FLJHH/iot-greenhouse-management-system/代码/上位机代码/说明.txt

登录id：8632
用户名和密码都是：123

index.html是主页
***********************************************
此文件具有访问数据库的功能，function db_request_option(type, table, option, arg_data, callback)
通过json格式的数据来判断请求的渠道并跳转到响应的登录页面，window.location.replace(pc_login_url);

***********************************************

main_9.html是主页
***********************************************
这段代码是一个HTML和Vue.js混合编写的桌面应用程序。它的功能包括导航栏、侧边栏、内容窗口和登录页面。以下是输入代码的解释：
代码结构：
使用<!DOCTYPE html>定义了一个HTML文档的声明。
使用<html>、<head>和<body>标签组织网页的结构。
在<head>中包含了<meta>标签、<link>标签和<style>标签。
在<body>中使用了Vue.js框架和Element UI组件。
实现原理：
使用Vue.js框架实现了一个单页应用（SPA），包括数据绑定、视图渲染和状态管理。
使用Element UI组件实现了一个美观的界面，包括导航栏、侧边栏和内容窗口。
使用了v-cloak指令来控制元素的显示和隐藏。
用途：
这是一个桌面应用程序，用于展示和操作数据。
用户可以通过导航栏和侧边栏快速定位到所需的页面和功能。
内容窗口展示了数据，用户可以查看和修改数据。
登录页面提供了用户登录和注册的功能。
***********************************************
login.html是登录页面

register.html是注册页面

user.html是用户信息页面

user_update.html是修改用户信息页面

user_update_pwd.html是修改密码页面

user_update_pwd_success.html是修改密码成功页面

user_update_success.html是修改用户信息成功页面

user_update_fail.html是修改用户信息失败页面

user_update_pwd_fail.html是修改密码失败页面

user_update_pwd_success.html是修改密码成功页面

user_update_pwd_fail.html是修改密码失败页面

user_update_pwd_success.html是修改密码成功页面

user_update_fail.html是修改用户信息失败页面
