FLJHH/iot-greenhouse-management-system/代码/上位机代码/html/login_page_3/asset/img1.png

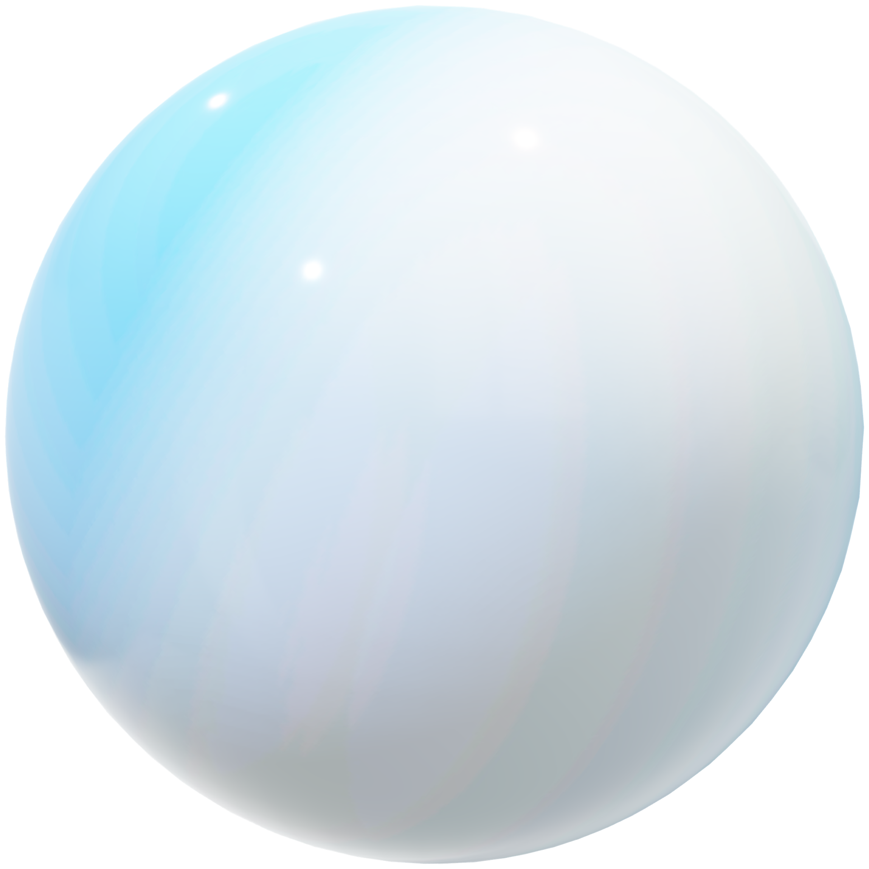
代码/上位机代码/html/login_page_3/asset/img1.png
