FLJHH/iot-greenhouse-management-system/代码/上位机代码/img/3.jpg

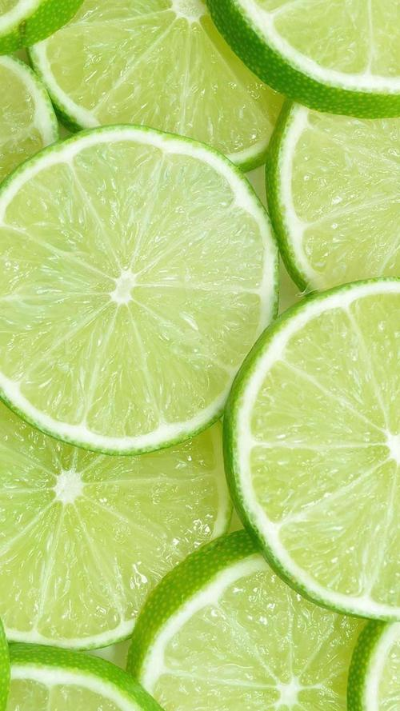
代码/上位机代码/img/3.jpg
