FLJHH/iot-greenhouse-management-system/代码/上位机代码/img/4.png

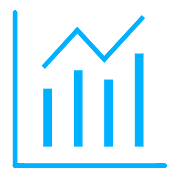
代码/上位机代码/img/4.png
