FLJHH/iot-greenhouse-management-system/代码/上位机代码/img/12.jpg

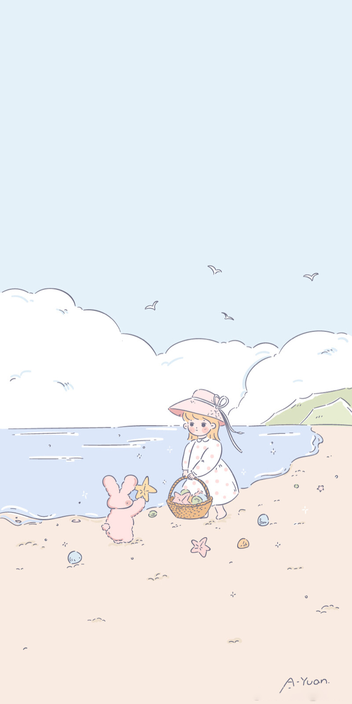
代码/上位机代码/img/12.jpg
