FLJHH/iot-greenhouse-management-system/代码/上位机代码/img/26.jpg

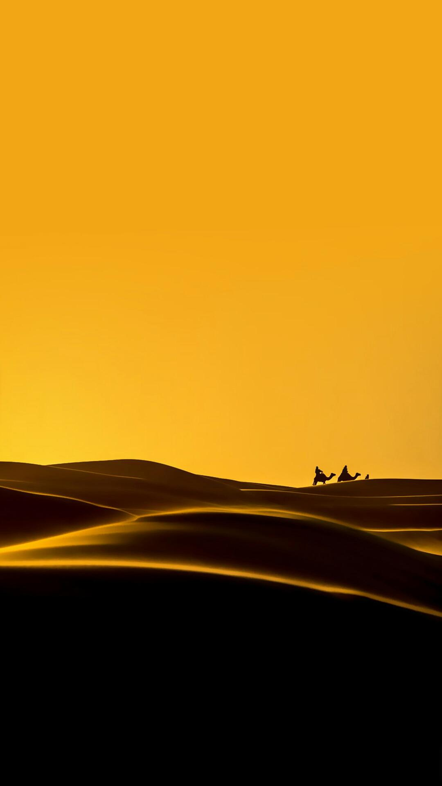
代码/上位机代码/img/26.jpg
