FLJHH/iot-greenhouse-management-system/代码/上位机代码/img/33.jpg

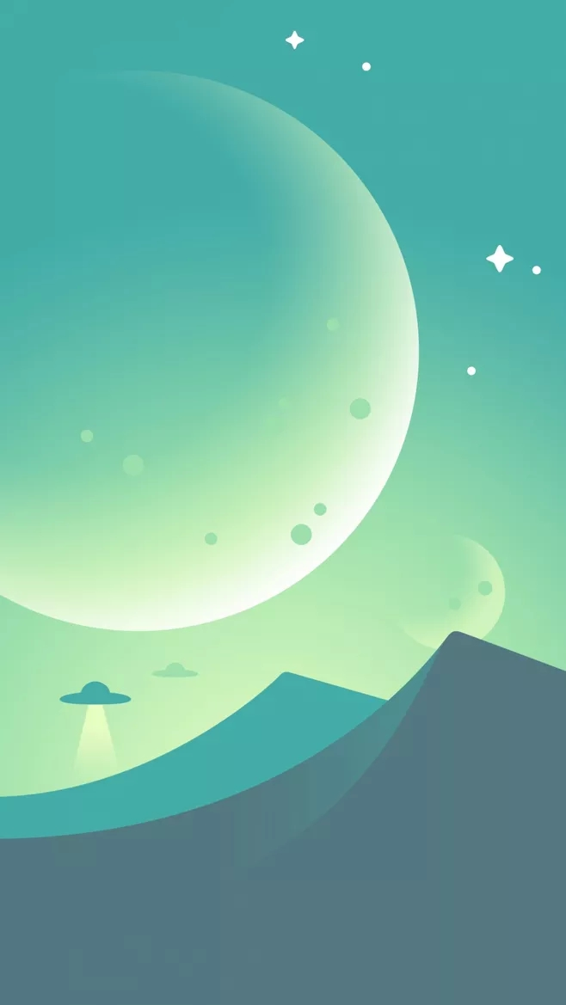
代码/上位机代码/img/33.jpg
