FLJHH/iot-greenhouse-management-system/代码/上位机代码/img/2512.jpg

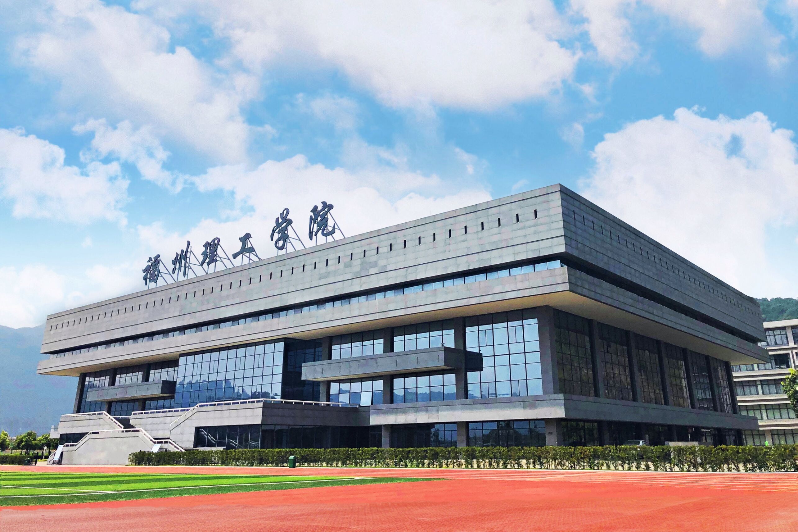
代码/上位机代码/img/2512.jpg
