FLJHH/iot-greenhouse-management-system/代码/上位机代码/img/pc/背景5.jpg

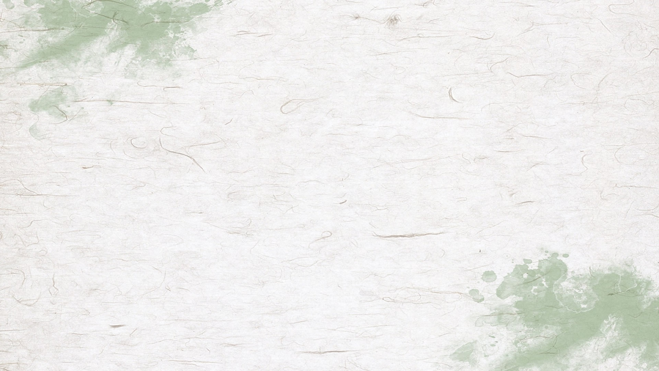
代码/上位机代码/img/pc/背景5.jpg
