FLJHH/iot-greenhouse-management-system/代码/上位机代码/img/腾讯云背景.jpg

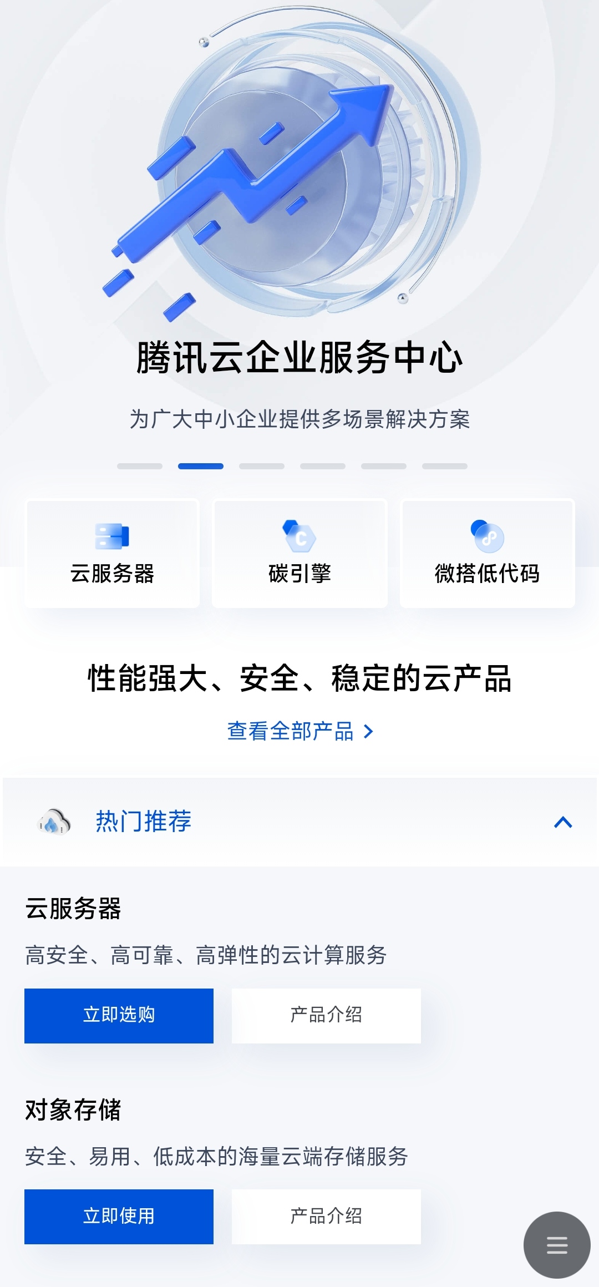
代码/上位机代码/img/腾讯云背景.jpg
