FLJHH/iot-greenhouse-management-system/代码/下位机代码/stm32-1/stm32-lib-softtimer/HARDWARE/GPIO_Init/GPIO_Init.c

#include "GPIO_Init.h"

// -------AO读取----

unsigned int Get_GPIO_Init_Mode_AO_PA0(void)
{
	unsigned int value;
	static unsigned char flag_is_init = 0;
	if (flag_is_init == 0)
	{
		flag_is_init = 1;
		Adc_Init_channel(0);
	}

	value = Get_ADC_channel(0); // channel and repeat times

	return value;
}

unsigned int Get_GPIO_Init_Mode_AO_PA1(void)
{
	unsigned int value;
	static unsigned char flag_is_init = 0;
	if (flag_is_init == 0)
	{
		flag_is_init = 1;
		Adc_Init_channel(1);
	}

	value = Get_ADC_channel(1); // channel and repeat times

	return value;
}

unsigned int Get_GPIO_Init_Mode_AO_PA2(void)
{
	unsigned int value;
	static unsigned char flag_is_init = 0;
	if (flag_is_init == 0)
	{
		flag_is_init = 1;
		Adc_Init_channel(2);
	}

	value = Get_ADC_channel(2); // channel and repeat times

	return value;
}

unsigned int Get_GPIO_Init_Mode_AO_PA3(void)
{
	unsigned int value;
	static unsigned char flag_is_init = 0;
	if (flag_is_init == 0)
	{
		flag_is_init = 1;
		Adc_Init_channel(3);
	}

	value = Get_ADC_channel(3); // channel and repeat times

	return value;
}
// 功能：获取GPIO初始化模式AO_PA4的值
// 参数：无
// 返回值：unsigned int类型的值
unsigned int Get_GPIO_Init_Mode_AO_PA4(void)
{
	unsigned int value;
	static unsigned char flag_is_init = 0; // 初始化标志位
	if (flag_is_init == 0) // 如果未初始化
	{
		flag_is_init = 1; // 初始化标志位设为1
		Adc_Init_channel(4); // 初始化ADC通道4
	}

	value = Get_ADC_channel(4); // 获取ADC通道4的值

	return value;
}
unsigned int Get_GPIO_Init_Mode_AO_PA5(void)
{
	unsigned int value;
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
		GPIO_Init(GPIOC, &GPIO_InitStructure);			  // 根据设定参数初始化GPIOA.8
		GPIO_ResetBits(GPIOC, GPIO_Pin_15);				  // 输出低
	}

	if (value)
	{
		GPIO_ResetBits(GPIOC, GPIO_Pin_15); // 输出低电平
	}
	else
	{
		GPIO_SetBits(GPIOC, GPIO_Pin_15); // 输出高
	}
}
