FLJHH/iot-greenhouse-management-system/代码/下位机代码/stm32-网关中转/stm32-lib-softtimer/HARDWARE/GPIO/GPIO.C

#include "gpio.h"
#include "delay.h"   //根据时钟晶振配置的延时函数
#include "sys.h"			//基础配置（包括 gpio输入输出简化 及变量名的简化

void GPIO_Init_Mode(void)
{

	GPIO_InitTypeDef GPIO_InitStructure;

	RCC_APB2PeriphClockCmd(RCC_APB2Periph_GPIOE, ENABLE); //使能PG,PD端口时钟

	GPIO_InitStructure.GPIO_Pin = GPIO_Pin_14;		  // 端口配置
	GPIO_InitStructure.GPIO_Mode = GPIO_Mode_Out_PP;  //设置成上拉输入
	GPIO_InitStructure.GPIO_Speed = GPIO_Speed_50MHz; //IO口速度为50MHz
	GPIO_Init(GPIOE, &GPIO_InitStructure);			  //根据设定参数初始化GPIOA.8
	GPIO_SetBits(GPIOE, GPIO_Pin_14);				  // 输出高

	// GPIO_InitStructure.GPIO_Pin = GPIO_Pin_9;				 //LED0-->PA.8 端口配置
	// GPIO_InitStructure.GPIO_Mode = GPIO_Mode_Out_PP; 		 //推挽输出
	// GPIO_InitStructure.GPIO_Speed = GPIO_Speed_50MHz;		 //IO口速度为50MHz
	// GPIO_Init(GPIOE, &GPIO_InitStructure);					 //根据设定参数初始化GPIOA.8
	// GPIO_ResetBits(GPIOE,GPIO_Pin_9);						 //PA.8 输出低

	// GPIO_InitStructure.GPIO_Pin = GPIO_Pin_9;	    		 //LED1-->PD.2 端口配置, 推挽输出
	// GPIO_Init(GPIOE, &GPIO_InitStructure);	  				 //推挽输出 ，IO口速度为50MHz
	// GPIO_SetBits(GPIOE,GPIO_Pin_9); 						 //PD.2 输出高
}

void InitSensor_Beep(void)
{

	GPIO_InitTypeDef GPIO_InitStructure;

	RCC_APB2PeriphClockCmd(RCC_APB2Periph_GPIOB, ENABLE); //使能PG,PD端口时钟

	GPIO_InitStructure.GPIO_Pin = GPIO_Pin_10;		  // 端口配置
	GPIO_InitStructure.GPIO_Mode = GPIO_Mode_Out_PP;  //设置成上拉输入
	GPIO_InitStructure.GPIO_Speed = GPIO_Speed_50MHz; //IO口速度为50MHz
	GPIO_Init(GPIOB, &GPIO_InitStructure);			  //根据设定参数初始化GPIOA.8
	GPIO_SetBits(GPIOB, GPIO_Pin_10);				  // 输出高 -- 低电平触发
}
 



void InitSensor_OUTPUT_DO2(void)
{

	GPIO_InitTypeDef GPIO_InitStructure;

	RCC_APB2PeriphClockCmd(RCC_APB2Periph_GPIOB, ENABLE); //使能PB端口时钟

	GPIO_InitStructure.GPIO_Pin = GPIO_Pin_12;		  // 端口配置
	GPIO_InitStructure.GPIO_Mode = GPIO_Mode_Out_PP;  //设置成上拉输入
	GPIO_InitStructure.GPIO_Speed = GPIO_Speed_50MHz; //IO口速度为50MHz
	GPIO_Init(GPIOB, &GPIO_InitStructure);			  //根据设定参数初始化GPIOA.8
	GPIO_ResetBits(GPIOB, GPIO_Pin_12);				  // 输出低
}

void InitSensor_OUTPUT_DO3(void)
{

	GPIO_InitTypeDef GPIO_InitStructure;

	RCC_APB2PeriphClockCmd(RCC_APB2Periph_GPIOB, ENABLE); //使能PB端口时钟

	GPIO_InitStructure.GPIO_Pin = GPIO_Pin_13;		  // 端口配置
	GPIO_InitStructure.GPIO_Mode = GPIO_Mode_Out_PP;  //设置成上拉输入
	GPIO_InitStructure.GPIO_Speed = GPIO_Speed_50MHz; //IO口速度为50MHz
	GPIO_Init(GPIOB, &GPIO_InitStructure);			  //根据设定参数初始化GPIOA.8
	GPIO_ResetBits(GPIOB, GPIO_Pin_13);				  // 输出低
}

void InitSensor_OUTPUT_DO4(void)
{

	GPIO_InitTypeDef GPIO_InitStructure;

	RCC_APB2PeriphClockCmd(RCC_APB2Periph_GPIOB, ENABLE); //使能PB端口时钟

	GPIO_InitStructure.GPIO_Pin = GPIO_Pin_14;		  // 端口配置
	GPIO_InitStructure.GPIO_Mode = GPIO_Mode_Out_PP;  //设置成上拉输入
	GPIO_InitStructure.GPIO_Speed = GPIO_Speed_50MHz; //IO口速度为50MHz
	GPIO_Init(GPIOB, &GPIO_InitStructure);			  //根据设定参数初始化GPIOA.8
	GPIO_ResetBits(GPIOB, GPIO_Pin_14);				  // 输出低
}

void InitSensor_OUTPUT_DO5(void)
{

	GPIO_InitTypeDef GPIO_InitStructure;

	RCC_APB2PeriphClockCmd(RCC_APB2Periph_GPIOB, ENABLE); //使能PB端口时钟

	GPIO_InitStructure.GPIO_Pin = GPIO_Pin_15;		  // 端口配置
	GPIO_InitStructure.GPIO_Mode = GPIO_Mode_Out_PP;  //设置成上拉输入
	GPIO_InitStructure.GPIO_Speed = GPIO_Speed_50MHz; //IO口速度为50MHz
	GPIO_Init(GPIOB, &GPIO_InitStructure);			  //根据设定参数初始化GPIOA.8
	GPIO_ResetBits(GPIOB, GPIO_Pin_15);				  // 输出低电平
}






void InitSensor_Jidianqi(void)
{

	GPIO_InitTypeDef GPIO_InitStructure;

	RCC_APB2PeriphClockCmd(RCC_APB2Periph_GPIOB, ENABLE); //使能PB端口时钟

	GPIO_InitStructure.GPIO_Pin = GPIO_Pin_7;		  // 端口配置
	GPIO_InitStructure.GPIO_Mode = GPIO_Mode_Out_PP;  //设置成上拉输入
	GPIO_InitStructure.GPIO_Speed = GPIO_Speed_50MHz; //IO口速度为50MHz
	GPIO_Init(GPIOB, &GPIO_InitStructure);			  //根据设定参数初始化GPIOA.8
	GPIO_ResetBits(GPIOB, GPIO_Pin_7);				  // 输出低电平
}




void InitSensor_Jidianqi_2(void)
{

	GPIO_InitTypeDef GPIO_InitStructure;

	RCC_APB2PeriphClockCmd(RCC_APB2Periph_GPIOB, ENABLE); //使能PB端口时钟

	GPIO_InitStructure.GPIO_Pin = GPIO_Pin_6;		  // 端口配置
	GPIO_InitStructure.GPIO_Mode = GPIO_Mode_Out_PP;  //设置成上拉输入
	GPIO_InitStructure.GPIO_Speed = GPIO_Speed_50MHz; //IO口速度为50MHz
	GPIO_Init(GPIOB, &GPIO_InitStructure);			  //根据设定参数初始化GPIOA.8
	GPIO_ResetBits(GPIOB, GPIO_Pin_6);				  // 输出低电平
}


void InitSensor_Jidianqi_3(void)
{

	GPIO_InitTypeDef GPIO_InitStructure;

	RCC_APB2PeriphClockCmd(RCC_APB2Periph_GPIOB, ENABLE); //使能PB端口时钟

	GPIO_InitStructure.GPIO_Pin = GPIO_Pin_5;		  // 端口配置
	GPIO_InitStructure.GPIO_Mode = GPIO_Mode_Out_PP;  //设置成上拉输入
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

	state = GPIO_ReadInputDataBit(GPIOB, GPIO_Pin_8);

	if (state == 0)
	{
		record = ((record << 1) | 0x01);
	}
	else
	{
		record = ((record << 1) & (~0x01));
	}

	if ((record & 0xf) == 0)
	{
		return (0);
	}
	else
	{
		return (1);
	}
}







void InitSensor_Renti(void)
{

	GPIO_InitTypeDef GPIOInit;
	RCC_APB2PeriphClockCmd(RCC_APB2Periph_GPIOB, ENABLE);
	GPIOInit.GPIO_Mode = GPIO_Mode_IPU;
	GPIOInit.GPIO_Pin = GPIO_Pin_9;
	GPIOInit.GPIO_Speed = GPIO_Speed_50MHz;
	GPIO_Init(GPIOB, &GPIOInit);
}


void InitSensor_Huoyan(void)
{

	GPIO_InitTypeDef GPIOInit;
	RCC_APB2PeriphClockCmd(RCC_APB2Periph_GPIOB, ENABLE);
	GPIOInit.GPIO_Mode = GPIO_Mode_IPU;
	GPIOInit.GPIO_Pin = GPIO_Pin_4;
	GPIOInit.GPIO_Speed = GPIO_Speed_50MHz;
	GPIO_Init(GPIOB, &GPIOInit);
}




unsigned char Get_Huoyan(void)
{

	static unsigned char record = 0;
	unsigned char i = 0;
	unsigned char state = 0;

	state = GPIO_ReadInputDataBit(GPIOB, GPIO_Pin_4);

	if (state == 0)
	{
		record = ((record << 1) | 0x01);
	}
	else
	{
		record = ((record << 1) & (~0x01));
	}

	if ((record & 0x7) == 0)   // 0x07   ==  00000111
	{
		return (0);
	}
	else
	{
		return (1);
	}
}





unsigned char Get_Renti(void)
{

	static unsigned char record = 0;
	unsigned char i = 0;
	unsigned char state = 0;

	state = GPIO_ReadInputDataBit(GPIOB, GPIO_Pin_9);

	if (state == 1)
	{
		record = ((record << 1) | 0x01);
	}
	else
	{
		record = ((record << 1) & (~0x01));
	}

	if ((record & 0x0f) == 0)
	{
		return (0);
	}
	else
	{
		return (1);
	}
}





void InitSensor_Key(void)  
{  
    GPIO_InitTypeDef GPIOInit;  
    RCC_APB2PeriphClockCmd(RCC_APB2Periph_GPIOA, ENABLE);  
      
    GPIOInit.GPIO_Mode = GPIO_Mode_IPU;   //上拉输入
    GPIOInit.GPIO_Pin = GPIO_Pin_8 ;  
    GPIOInit.GPIO_Speed = GPIO_Speed_50MHz;  
    GPIO_Init(GPIOA, &GPIOInit);  
}  



  
unsigned char Get_Key(void)  
{  
	
	if(GPIO_ReadInputDataBit(GPIOA, GPIO_Pin_8) == 0)
	{
		delay_ms(10);
		
		if(GPIO_ReadInputDataBit(GPIOA, GPIO_Pin_8) == 0)
		{
			return 1;
		}
	}
	return 0;
}  
