FLJHH/iot-greenhouse-management-system/代码/下位机代码/stm32-网关中转/stm32-lib-softtimer/HARDWARE/PWM/pwm.c

#include "pwm.h"
#include "led.h"

/********************************************	 
 TIMx 
TIM1_BKIN->PB12
TIM1_CH1N->PB13
TIM1_CH2N->PB14
TIM1_CH3N->PB15
TIM1_CH1->PA8
TIM1_CH2->PA9
TIM1_CH3->PA10
TIM1_CH4->PA11
TIM1_ETR->PA12
TIM2_CH1->PA0
TIM2_CH2->PA1
TIM2_CH3->PA2
TIM2_Ch4->PA3
TIM3_ETR->PD2
TIM3_CH1->PB4-PC6-Remap
TIM3_CH2->PB5-PC7-Remap
TIM3_CH3->PC8-Remap
TIM3_CH4->PC9-Remap
TIM4_CH1->PD12-Remap
TIM4_CH2->PD13-Remap
TIM4_CH3->PD14-Remap
TIM4_CH4->PD15-Remap
TIM5_CH1->PA0
TIM5_CH2->PA1
TIM5_CH3->PA2
TIM5_CH4->PA3
TIM8_ETR->PA0
TIM8_BKIN->PA6
TIM8_CH1N->PA7
TIM8_CH2N->PB0
TIM8_CH3N->PB1
TIM8_CH1->PC6
TIM8_CH2->PC7
TIM8_CH3->PC8
TIM8_CH4->PC9
*************************************************************/ 	  



//PWM输出初始化
//arr：自动重装值
//psc：时钟预分频数
//TIM_SetCompare1(TIM1,NUM); --控制TIM1 CH1 占空比为NUM

void TIM1_PWM_Init(u16 arr,u16 psc)
{  
   GPIO_InitTypeDef GPIO_InitStructure;
  TIM_TimeBaseInitTypeDef  TIM_TimeBaseStructure;
  TIM_OCInitTypeDef  TIM_OCInitStructure;

  RCC_APB2PeriphClockCmd(RCC_APB2Periph_TIM1, ENABLE);		// 
  RCC_APB2PeriphClockCmd(RCC_APB2Periph_GPIOA , ENABLE);  //使能GPIO外设时钟使能
                                                                        

   //设置该引脚为复用输出功能,输出TIM1 CH1的PWM脉冲波形
  GPIO_InitStructure.GPIO_Pin = GPIO_Pin_10 | GPIO_Pin_11; //TIM_CH1 TIM_CH4
  GPIO_InitStructure.GPIO_Mode = GPIO_Mode_AF_PP;  //复用推挽输出
  GPIO_InitStructure.GPIO_Speed = GPIO_Speed_50MHz;
  GPIO_Init(GPIOA, &GPIO_InitStructure);

  
  TIM_TimeBaseStructure.TIM_Period = arr-1; //设置在下一个更新事件装入活动的自动重装载寄存器周期的值  80K
  TIM_TimeBaseStructure.TIM_Prescaler =psc-1; //设置用来作为TIMx时钟频率除数的预分频值  不分频
  TIM_TimeBaseStructure.TIM_ClockDivision = 0; //设置时钟分割:TDTS = Tck_tim
  TIM_TimeBaseStructure.TIM_CounterMode = TIM_CounterMode_Up;  //TIM向上计数模式
  TIM_TimeBaseInit(TIM1, &TIM_TimeBaseStructure); //根据TIM_TimeBaseInitStruct中指定的参数初始化TIMx的时间基数单位



 
  TIM_OCInitStructure.TIM_OCMode = TIM_OCMode_PWM2; //选择定时器模式:TIM脉冲宽度调制模式2
  TIM_OCInitStructure.TIM_OutputState = TIM_OutputState_Enable; //比较输出使能
  TIM_OCInitStructure.TIM_Pulse = 0; //设置待装入捕获比较寄存器的脉冲值
  TIM_OCInitStructure.TIM_OCPolarity = TIM_OCPolarity_High; //输出极性:TIM输出比较极性高
  TIM_OC1Init(TIM1, &TIM_OCInitStructure);  //根据TIM_OCInitStruct中指定的参数初始化外设TIMx
	
	
	TIM_OC1Init(TIM1, &TIM_OCInitStructure);  //根据TIM_OCInitStruct中指定的参数初始化外设TIMx ----------- TIM_OC3 通道3
  TIM_OC4Init(TIM1, &TIM_OCInitStructure);  //根据TIM_OCInitStruct中指定的参数初始化外设TIMx ----------- TIM_OC4 通道4


  TIM_CtrlPWMOutputs(TIM1,ENABLE);  //MOE 主输出使能 

	// TIM_OC1PreloadConfig(TIM1, TIM_OCPreload_Enable);  //CH1预装载使能  
  // TIM_OC2PreloadConfig(TIM1, TIM_OCPreload_Enable);  //CH1预装载使能  
  TIM_OC3PreloadConfig(TIM1, TIM_OCPreload_Enable);  //CH1预装载使能  
  TIM_OC4PreloadConfig(TIM1, TIM_OCPreload_Enable);  //CH预装载使能
  
  TIM_ARRPreloadConfig(TIM1, ENABLE); //使能TIMx在ARR上的预装载寄存器
  
  TIM_Cmd(TIM1, ENABLE);  //使能TIM1
	
	TIM_SetCompare3(TIM1,99);
	TIM_SetCompare4(TIM1,99);
	
}



void SetSensor_Pwm10(unsigned char value)
{
  if(value > 99)
  {
    value = 99;
  }

  TIM_SetCompare3(TIM1,value);
  
}


void SetSensor_Pwm11(unsigned char value)
{
  if(value > 99)
  {
    value = 99;
  }

  TIM_SetCompare4(TIM1,value);
  
}
 










void TIM2_PWM_Init(u16 arr,u16 psc)
{

   GPIO_InitTypeDef GPIO_InitStructure;
  TIM_TimeBaseInitTypeDef  TIM_TimeBaseStructure;
  TIM_OCInitTypeDef  TIM_OCInitStructure;

  RCC_APB1PeriphClockCmd(RCC_APB1Periph_TIM2, ENABLE);	//
   
  RCC_APB2PeriphClockCmd(RCC_APB2Periph_GPIOA , ENABLE);  //使能GPIO外设时钟使能
                                                                        

   //设置该引脚为复用输出功能,输出TIM2 CH1的PWM脉冲波形
  GPIO_InitStructure.GPIO_Pin = GPIO_Pin_2 | GPIO_Pin_3 ; //TIM_CH3-2 TIM_CH4-3

  GPIO_InitStructure.GPIO_Mode = GPIO_Mode_AF_PP;  //复用推挽输出
  GPIO_InitStructure.GPIO_Speed = GPIO_Speed_50MHz;
  GPIO_Init(GPIOA, &GPIO_InitStructure);

  
  TIM_TimeBaseStructure.TIM_Period = arr-1; //设置在下一个更新事件装入活动的自动重装载寄存器周期的值  80K
  TIM_TimeBaseStructure.TIM_Prescaler =psc-1; //设置用来作为TIMx时钟频率除数的预分频值  不分频
  TIM_TimeBaseStructure.TIM_ClockDivision = 0; //设置时钟分割:TDTS = Tck_tim
  TIM_TimeBaseStructure.TIM_CounterMode = TIM_CounterMode_Up;  //TIM向上计数模式
  TIM_TimeBaseInit(TIM2, &TIM_TimeBaseStructure); //根据TIM_TimeBaseInitStruct中指定的参数初始化TIMx的时间基数单位

 
  TIM_OCInitStructure.TIM_OCMode = TIM_OCMode_PWM2; //选择定时器模式:TIM脉冲宽度调制模式2
  TIM_OCInitStructure.TIM_OutputState = TIM_OutputState_Enable; //比较输出使能
  TIM_OCInitStructure.TIM_Pulse = 0; //设置待装入捕获比较寄存器的脉冲值
  TIM_OCInitStructure.TIM_OCPolarity = TIM_OCPolarity_High; //输出极性:TIM输出比较极性高

//  TIM_OC1Init(TIM2, &TIM_OCInitStructure);  //根据TIM_OCInitStruct中指定的参数初始化外设TIMx ----------- TIM_OC3 通道3
//  TIM_OC2Init(TIM2, &TIM_OCInitStructure);  //根据TIM_OCInitStruct中指定的参数初始化外设TIMx ----------- TIM_OC3 通道3
  TIM_OC3Init(TIM2, &TIM_OCInitStructure);  //根据TIM_OCInitStruct中指定的参数初始化外设TIMx ----------- TIM_OC3 通道3
  TIM_OC4Init(TIM2, &TIM_OCInitStructure);  //根据TIM_OCInitStruct中指定的参数初始化外设TIMx ----------- TIM_OC4 通道4

  TIM_CtrlPWMOutputs(TIM2,ENABLE);  //MOE 主输出使能 
//  TIM_OC1PreloadConfig(TIM2, TIM_OCPreload_Enable);  //CH3预装载使能
//  TIM_OC2PreloadConfig(TIM2, TIM_OCPreload_Enable);  //CH3预装载使能
  TIM_OC3PreloadConfig(TIM2, TIM_OCPreload_Enable);  //CH3预装载使能  
  TIM_OC4PreloadConfig(TIM2, TIM_OCPreload_Enable);  //CH4预装载使能

  TIM_ARRPreloadConfig(TIM2, ENABLE); //使能TIMx在ARR上的预装载寄存器
  
  TIM_Cmd(TIM2, ENABLE);  //使能TIM2
	
	
	TIM_SetCompare3(TIM2,99);
	TIM_SetCompare4(TIM2,99);
 
   
}
