FLJHH/iot-greenhouse-management-system/代码/下位机代码/stm32-网关中转/stm32-lib-softtimer/HARDWARE/DS18B20/ds18b20.h

#ifndef __DS18B20_H
#define __DS18B20_H 
#include "sys.h"   
 

//IO方向设置
//为了精确起见，这里采用寄存器写法
#define DS18B20_IO_IN()  {GPIOA->CRL&=0XFFFFFFF0;GPIOA->CRL|=8<<0;}
#define DS18B20_IO_OUT() {GPIOA->CRL&=0XFFFFFFF0;GPIOA->CRL|=3<<0;}
////IO操作函数											   
#define	DS18B20_DQ_OUT PAout(0) //数据端口	PA0 
#define	DS18B20_DQ_IN  PAin(0)  //数据端口	PA0 
   	
u8 DS18B20_Init(void);//初始化DS18B20
short DS18B20_Get_Temp(void);//获取温度
void DS18B20_Start(void);//开始温度转换
void DS18B20_Write_Byte(u8 dat);//写入一个字节
u8 DS18B20_Read_Byte(void);//读出一个字节
u8 DS18B20_Read_Bit(void);//读出一个位
u8 DS18B20_Check(void);//检测是否存在DS18B20
void DS18B20_Rst(void);//复位DS18B20    
#endif
