FLJHH/iot-greenhouse-management-system/代码/下位机代码/stm32-网关中转/stm32-lib-softtimer/HARDWARE/chaoshengbo/UltrasonicWave.h

#ifndef __UltrasonicWave_H
#define	__UltrasonicWave_H

//#define OPEN_UltrasonicWave_CH1 
// #define OPEN_UltrasonicWave_CH2 
#define OPEN_UltrasonicWave_CH3 
// #define OPEN_UltrasonicWave_CH4 



#define	TRIG_PORT_ch1      GPIOB		//TRIG       
#define	ECHO_PORT_ch1      GPIOB		//ECHO 
#define	TRIG_PIN_ch1       GPIO_Pin_8   //TRIG       
#define	ECHO_PIN_ch1       GPIO_Pin_7	//ECHO   

#define	TRIG_PORT_ch2      GPIOB		//TRIG       
#define	ECHO_PORT_ch2      GPIOB		//ECHO 
#define	TRIG_PIN_ch2      GPIO_Pin_6   //TRIG       
#define	ECHO_PIN_ch2       GPIO_Pin_5	//ECHO   

#define	TRIG_PORT_ch3      GPIOB		//TRIG       
#define	ECHO_PORT_ch3      GPIOB		//ECHO 
#define	TRIG_PIN_ch3      GPIO_Pin_4   //TRIG       
#define	ECHO_PIN_ch3       GPIO_Pin_3	//ECHO   

#define	TRIG_PORT_ch4      GPIOB		//TRIG       
#define	ECHO_PORT_ch4      GPIOB		//ECHO 
#define	TRIG_PIN_ch4       GPIO_Pin_2   //TRIG       
#define	ECHO_PIN_ch4       GPIO_Pin_1	//ECHO   






void UltrasonicWave_Init(void);  //超声波初始化
float UltrasonicWave_GetDistance_ch1(void);  //读取距离 -- 单位 cm
float UltrasonicWave_GetDistance_ch2(void);  //读取距离 -- 单位 cm
float UltrasonicWave_GetDistance_ch3(void);  //读取距离 -- 单位 cm
float UltrasonicWave_GetDistance_ch4(void);  //读取距离 -- 单位 cm



#endif /* __UltrasonicWave_H */
